sanworks/Teensy4_to_HiFiBerryDAC/README.md

# Teensy4_to_HiFiBerryDAC
Breakout boards to interface PJRC Teensy 4.X with HiFiBerry DAC boards
