sanworks/Teensy4_to_HiFiBerryDAC/PCBs/r1.1/Teensy4_HiFiBerry_r1_1_TopMount.brd

## EAGLE design PCBs/r1.1/Teensy4_HiFiBerry_r1_1_TopMount.brd (2021-07-11)

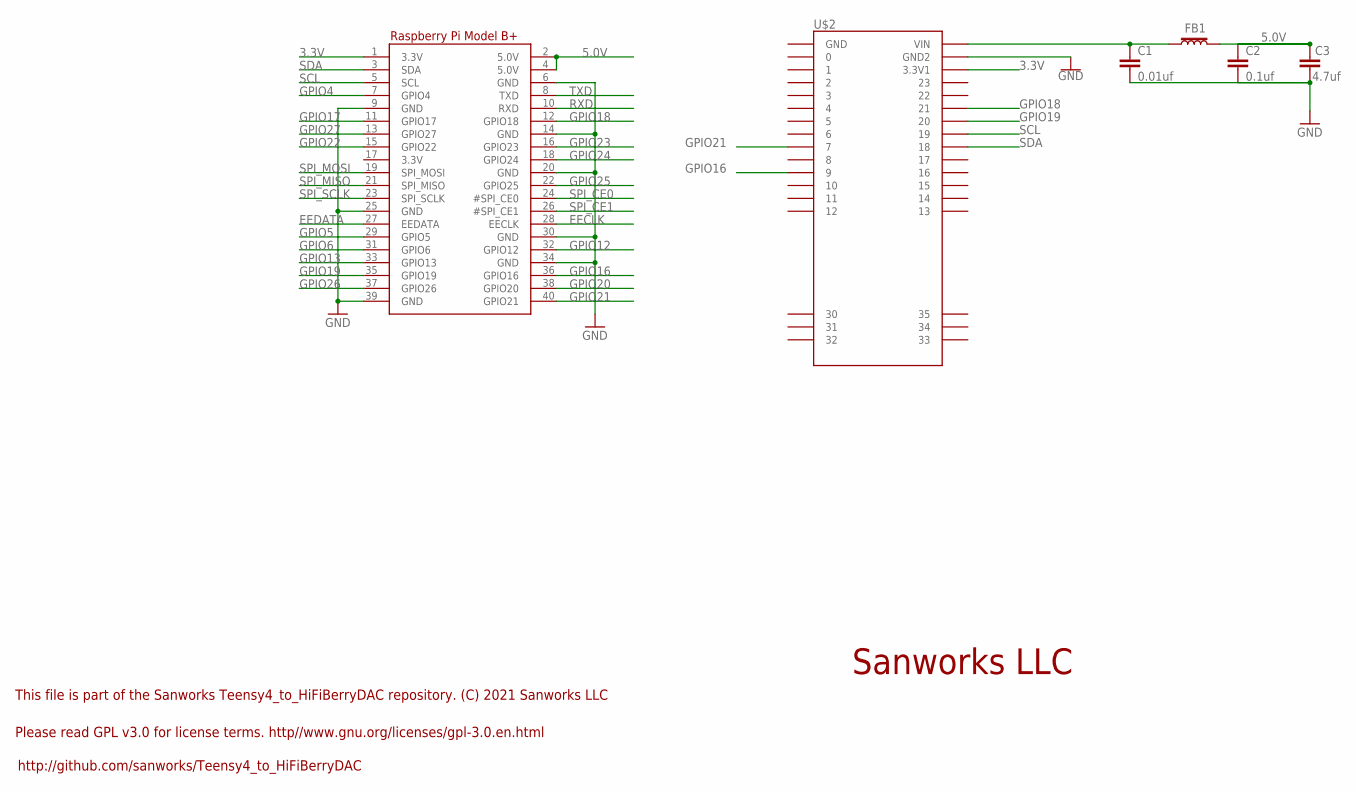
[picture p1: schematic Teensy4_HiFiBerry_r1_1_TopMount.sch]

Parts:
C1: 0.01uf; 0805
C2: 0.1uf; 0805
C3: 4.7uf; 1206@2
FB1: FERRITE_BEAD-0603; 0603
RPI1: RASPBERRYPI_BPLUS_IDC; 2X20
U$2: TEENSY4-4.1_FORAUDIO

Connections:
3.3V: RPI1.1 (3.3V), U$2.3V3_LO (3.3V1)
5.0V: C2.1, C3.2, FB1.2, RPI1.2 (5.0V), RPI1.4 (5.0V)
EECLK: RPI1.28 (EECLK)
EEDATA: RPI1.27 (EEDATA)
GND: C1.2, C2.2, C3.1, RPI1.6 (GND), RPI1.9 (GND), RPI1.14 (GND), RPI1.20 (GND), RPI1.25 (GND), RPI1.30 (GND), RPI1.34 (GND), RPI1.39 (GND), U$2.GND (GND2)
GPIO4: RPI1.7 (GPIO4)
GPIO5: RPI1.29 (GPIO5)
GPIO6: RPI1.31 (GPIO6)
GPIO12: RPI1.32 (GPIO12)
GPIO13: RPI1.33 (GPIO13)
GPIO16: RPI1.36 (GPIO16), U$2.9
GPIO17: RPI1.11 (GPIO17)
GPIO18: RPI1.12 (GPIO18), U$2.21/A7 (21)
GPIO19: RPI1.35 (GPIO19), U$2.20/A6 (20)
GPIO20: RPI1.38 (GPIO20)
GPIO21: RPI1.40 (GPIO21), U$2.7
GPIO22: RPI1.15 (GPIO22)
GPIO23: RPI1.16 (GPIO23)
GPIO24: RPI1.18 (GPIO24)
GPIO25: RPI1.22 (GPIO25)
GPIO26: RPI1.37 (GPIO26)
GPIO27: RPI1.13 (GPIO27)
RXD: RPI1.10 (RXD)
SCL: RPI1.5 (SCL), U$2.19/A5/SCL (19)
SDA: RPI1.3 (SDA), U$2.18/A4/SDA (18)
SPI_CE0: RPI1.24 (#SPI_CE0)
SPI_CE1: RPI1.26 (#SPI_CE1)
SPI_MISO: RPI1.21 (SPI_MISO)
SPI_MOSI: RPI1.19 (SPI_MOSI)
SPI_SCLK: RPI1.23 (SPI_SCLK)
TXD: RPI1.8 (TXD)
VUSB: C1.1, FB1.1, U$2.VIN

Notes on the sheet:
http://github.com/sanworks/Teensy4_to_HiFiBerryDAC
Please read GPL v3.0 for license terms. http//www.gnu.org/licenses/gpl-3.0.en.html
This file is part of the Sanworks Teensy4_to_HiFiBerryDAC repository. (C) 2021 Sanworks LLC
Sanworks LLC

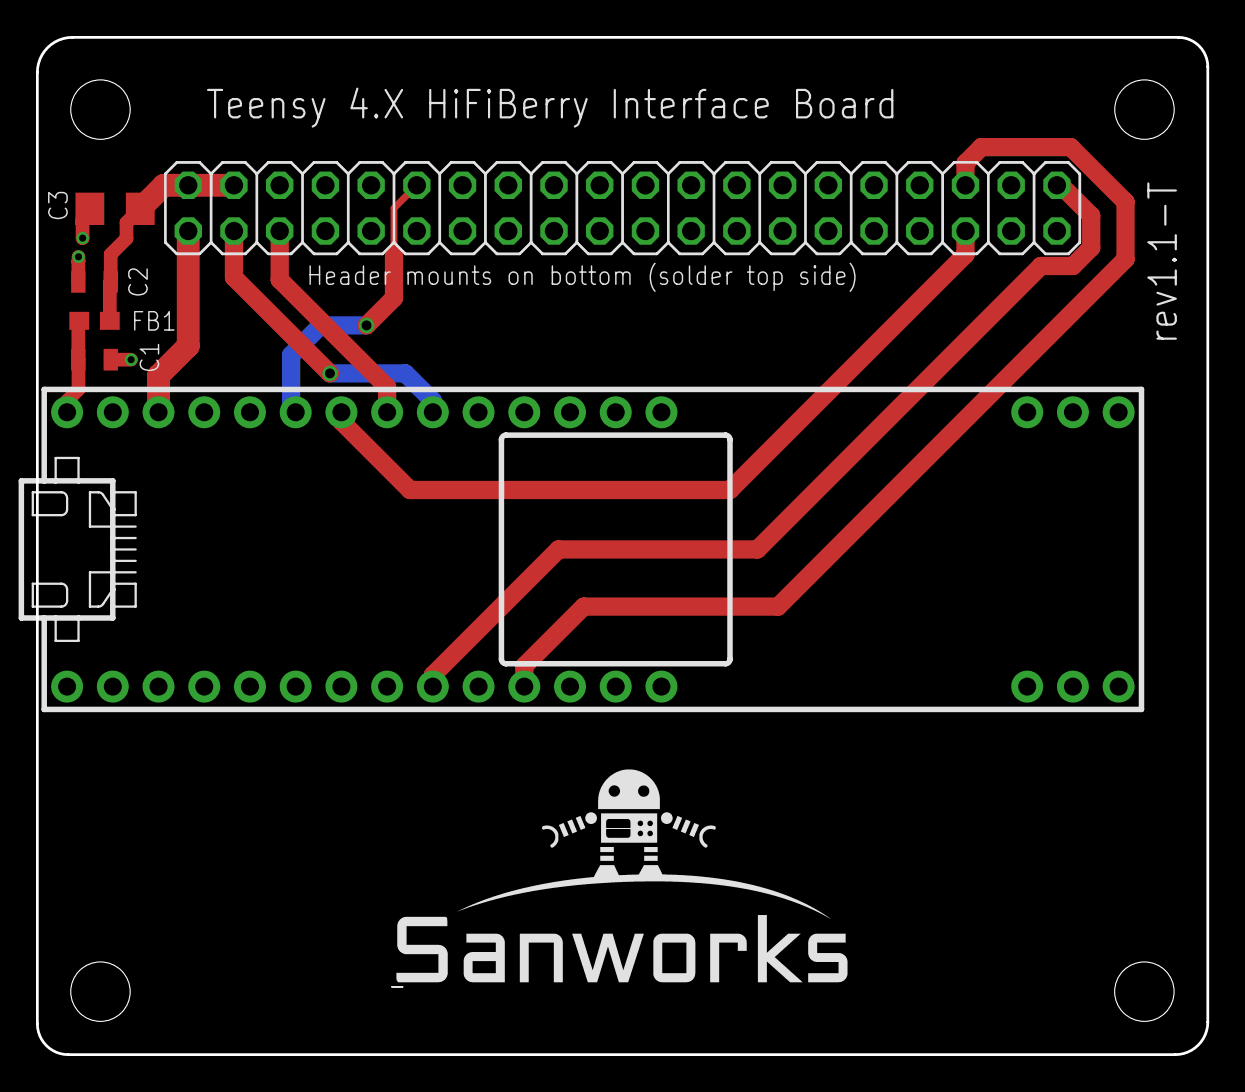
[picture p2: board Teensy4_HiFiBerry_r1_1_TopMount.brd from above]

Board: 2 copper layers, 65.0 x 56.5 mm, 7 parts (0 on the bottom side), 10 nets.

Other parts of the board:
U$1: SANWORKS_LOGO
