sanworks/Teensy4_to_HiFiBerryDAC/(commit log)

2021-02-09 -Fixed bit clock divider. I2S master mode now plays audio at the correct sampling rate
    [SineWaveSweep.ino]
2021-02-17 -Added support for DAC2 Pro -Reconfigured device selection macros
2021-02-20 -Changed default audio memory to accomodate more applications -Changed sine sweep range to match human hearing range -Added warning about performance issue with top-mount version of the PCB
    [SineWaveSweep.ino]
2021-02-25 -Added example sketches to configure board in USB passthrough mode (i.e. to make it act as a USB sound card for the PC) for DAC2 Pro and DAC2 HD
2021-02-28 -Updated notes to reflect that top-mount board issue specifically affects DAC2 HD
2021-07-11 -Updated PCB design to v1.1. The new design adds USB power filtering. This fixes the DAC2 HD stability issue with v1.0
    [Teensy4_HiFiBerry_r1_1_BottomMount.brd, Teensy4_HiFiBerry_r1_1_BottomMount.sch, Teensy4_HiFiBerry_r1_1_TopMount.brd, Teensy4_HiFiBerry_r1_1_TopMount.sch]
