sanworks/Teensy4_to_HiFiBerryDAC/(notices)

Notices in the files:
Arduino/USB Sound Card/USBSoundCard_DAC2_PRO/USBSoundCard_DAC2_PRO.ino:
This program is free software: you can redistribute it and/or modify
it under the terms of the GNU General Public License as published by
the Free Software Foundation, version 3.
parts and their libraries:
microbuilder: This work is placed in the public domain, and may be freely used for commercial and non-commercial work with the following conditions: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
SparkFun-Capacitors: Licensing: Creative Commons ShareAlike 4.0 International - https://creativecommons.org/licenses/by-sa/4.0
